Shuri-101/IMU-Dev-board/README.md

# IMU STM32STM32G431CBT6 DEV BOARD:




Hello, this is just a project for me to get some experience and learn about data busses like SPI (Serial Peripheral Interface), UART (Universal Asynchronous Receiver/Transmitter) and I2C (Inter-Integrated Circuit) and learn how to program sensors like IMUs, barometers, altimeters, GPS etc. This because I hope to design a flight computer for a drone or active stabilized rocket so yeah. 

## PCB
### About the board:

This board contains: 
- IMU (LSM6DS3TR-C)
- x6 GPIO headers
- x2 I2C headers (I2C 1 and I2C 2)
- x1 UART header (UART2)
- x2 SPI Headers (SPI 2, SPI3)
- x2 ADC headers
- x2 PWM headers
- x2 5V headers
- x4 3.3V headers
- x6 GND headers

### Schematic:


Since I had 48pins on my MCU I thought might as well use them and connect them to headers so I can use them later to connect other sensors and stuff.

Note for beginners: Decoupling capacitors are meant to smooth out power spikes and dips that might cause logic errors in the MCU, they also act as filtering capacitors keeping noise off sensitive rails like analogue (noise is unwanted voltage that you did not put there) as analogue data is the measure of voltage. 

Example of my decoupling capacitors are: 



Note that the capacitors are placed in parallel to the 3V3 line. 4.7uF is a bulk capacitors meant to refill the small capacitors between the spikes and dips that get drained very quickly during the spikes and dips. 

For more info about decoupling watch: 
https://www.youtube.com/watch?v=u40kX1DYKdA

### Why I chose these parts?

- I chosen the STM32STM32G431CBTX since it offered FPU, CRC and a mathematical accelerator which are needed to control these sensors, I chosen the LQFP-48 package since its easier to solder and it was the only variant available to buy at the time.
- FPU, a floating point unit allows you to work with floating point numbers such as a fraction, decimals etc 100x faster than a MCU without a FPU, since sensors output raw numbers that need to converted into data requires floating point maths hundreds of times per second.
- DSP, Digital Signal Processing lets you do fast repeated multiply-and-add on a stream of numbers, which is needed to do maths for the sensors roughly twice as fast than a MCU without it.

- I chose the LSM6DS3TR-C as its cheap has 6 axis and a +/- 2000 degrees / second and it has +/- 16g which works for learning how to program and design a PCB for an IMU. 

### Layers

#### Layer 1 (Main signal routing layer)
- In this layer I routed most of my signals + decupling / filtering capcitors (since they need to be placed as close to the thing its meant to decoupling / filter around 5mm max) taking care to have proper clearance from aggressive signals such as SCK to avoid crosstalk and interference from other signals.
- I also used local copper pours to create a low impedance route to GND.
- LDO is placed far away from IMU at the opposite end of the board to prevent the heat it generates from interfering with the readings.



#### Layer 2 (Ground Plane):
- This layer is a layer of copper connected ground aka "ground plane" and offers a low impedance path (simple terms path of low total resistance) to GND and also acts as a reference plane for signal return currents.
- Notice I have not routed anything on this layer, this is to maintain a unbroken reference plane otherwise signal return currents will have to loop around interfering with other signals.
- Using a ground plane also makes way way way easier to route your GND traces instead of using long traces back to power supply.
  


#### Layer 3 (3V3 Power Plane):
- This layer is another layer of copper but this time its connected to 3V3 from my LOW Dropout Converter which converts 5V --> 3.3V cause MCUs and my IMU runs on 3.3v logic.
- The 3v3 plane makes it easier to route my power supplies to my components that need it as its saves room as you can see from the picture I just use vias to route up from the plane to the MCU.
- Here you can see I routed signals here because I had no other choice as this board is quite small, this inevitably caused islands of copper to form on the PCB meaning I had to create localised copper pours on layer 3 to stitch these islands togther.



#### Layer 4 (3V3 stitching and Signal routing):
- In this layer I also used it to route signals I could not route on other layers as I had no room.
- I also used this layer to stitch the 3V3 plane up.
- The signals on this layer references with the 3V3 power plane because decoupling capacitors tie 3V3 and GND together.



## BOM:
To get these parts I recommend LCSC since they offer cheap global shipping and are available with JLCPCB assemble option.
To get these parts simply type the LSCC part code into the search bar of their website.
#### Parts:
USING LCSC:
- C967633: IMU

- C529355: MCU

- C6186: LDO

- C20608785: YELLOW LED

- C2894893: USB-C PORT

- C19171391: RED LED

- C33546008: 22uF MLCC XR5 (Filtering)

- C36911367: 100nF MLCC XR7 (Decoupling)

- C107365: 4.7uF MLCC XR7 (Bulk decoupling)

- C53282227: 1uF MLCC XR7

- C519909: 10nF MLCC XR7

- C118848: 5.1K Resistor

- C54921199: 470 Resistor

- C54921203: 4.7K Resistor

- C54921094: 10K Resistor


#### Estimated total for components:


#### PCB manufacturing costs:


#### TOTAL:
TOTAL COSTS: $54.03

## Firmware:
Since I don't know how to code in C and as I mentioned at the start this board is meant to get me to learn how to code, ill just send the config file for the IMU pins ONLY since I dont know what other things I want to plug into the board yet, and that is decide by the end user, but I'll set up the main configs for the MCU like clock SWD(for programming) and pins for the IMU. Also will need to learn fully about clocks, how they work, and how to configure data lines in CUBE MX...
