Shuri-101/IMU-Dev-board/BOM.md

# IMU Dev board – bill of materials

<!-- Generated by Half Life from project cmv2b11c403c001q3gejw6bb5. Edits here are overwritten on the next sync. -->
<!-- Generated: 2026-10-12T01:29:27.425Z -->

> [!NOTE]
> This parts list is mirrored from [Half Life](https://halflife.hackclub.com). Editing it here will not change the platform's copy, and the next sync overwrites this file.

| Week | Tier | Parts funding |
| --- | --- | --- |
| Week 1 | Tier 2 | $65.00 |

| Part | What it's for | Qty | Unit | Total | Vendor |
| --- | --- | --- | --- | --- | --- |
| [LSM6DS3TR-C](https://www.lcsc.com/product-detail/C967633.html) | LGA-14(2.5x3) IMUs (Inertial Measurement Units) RoHS | 2 | $1.53 | $3.06 | [LCSC](https://www.lcsc.com/product-detail/C967633.html) |
| [STM32G431CBT6](https://www.lcsc.com/product-detail/C529355.html) | ARM Cortex-M4F 32 Bit 170MHz LQFP-48(7x7) Microcontrollers RoHS | 2 | $5.07 | $10.14 | [LCSC](https://www.lcsc.com/product-detail/C529355.html) |
| [AMS1117-3.3](https://www.lcsc.com/product-detail/C6186.html) | 3.3V Positive Fixed SOT-223 Voltage Regulators - Linear, Low Drop Out (LDO) Regulators RoHS | 5 | $0.21 | $1.05 | [LCSC](https://www.lcsc.com/product-detail/C6186.html) |
| [YLED0805Y](https://www.lcsc.com/product-detail/C20608785.html) | Yellow 598nm LED Indication - Discrete 1.8V~2.4V 0805 | 50 | $0.01 | $0.50 | [LCSC](https://www.lcsc.com/product-detail/C20608785.html) |
| [HC-TYPE-C-6P-01A](https://www.lcsc.com/product-detail/C2894893.html) | USB-C (USB TYPE-C) Receptacle Connector 6 Position Surface Mount, Right Angle | 10 | $0.05 | $0.50 | [LCSC](https://www.lcsc.com/product-detail/C2894893.html) |
| [YLED0805R](https://www.lcsc.com/product-detail/C19171391.html) | Red 645nm LED Indication - Discrete 1.8V~2.4V 0805 | 100 | $0.01 | $1.00 | [LCSC](https://www.lcsc.com/product-detail/C19171391.html) |
| [HGC0805R5226M160NSLJ](https://www.lcsc.com/product-detail/C33546008.html) | 22uF ±20% 16V Ceramic Capacitor X5R 0805 | 5 | $0.10 | $0.50 | [LCSC](https://www.lcsc.com/product-detail/C33546008.html) |
| [CGA0805X7R104K160KT](https://www.lcsc.com/product-detail/C36911367.html) | 100nF ±10% 16V Ceramic Capacitor X7R 0805 | 100 | $0.01 | $1.00 | [LCSC](https://www.lcsc.com/product-detail/C36911367.html) |
| [CL21B475KOFNNNE](https://www.lcsc.com/product-detail/C107365.html) | 4.7uF ±10% 16V Ceramic Capacitor X7R 0805 | 10 | $0.04 | $0.40 | [LCSC](https://www.lcsc.com/product-detail/C107365.html) |
| [CGA0805X7R105J160MT](https://www.lcsc.com/product-detail/C53282227.html) | 1uF X7R ±5% 16V 0805 Ceramic Capacitors | 10 | $0.04 | $0.40 | [LCSC](https://www.lcsc.com/product-detail/C53282227.html) |
| [CC0805KRX7R7BB103](https://www.lcsc.com/product-detail/C519909.html) | 10nF ±10% 16V Ceramic Capacitor X7R 0805 | 50 | $0.01 | $0.50 | [LCSC](https://www.lcsc.com/product-detail/C519909.html) |
| [RS-05K5101FT](https://www.lcsc.com/product-detail/C118848.html) | 5.1kΩ ±1% 125mW 0805 Thick Film Resistor | 100 | $0.00 | $0.00 | [LCSC / ERROR WITH COST PLS CHECK](https://www.lcsc.com/product-detail/C118848.html) |
| [HRC0805F4700FNTN](https://www.lcsc.com/product-detail/C54921199.html) | 125mW 470Ω 150V Thick Film Resistor ±1% ±100ppm/℃ 0805 Chip Resistor - Surface Mount | 100 | $0.00 | $0.00 | [LCSC / ERROR WITH COST PLS CHECK](https://www.lcsc.com/product-detail/C54921199.html) |
| [HRC0805F4701FNTN](https://www.lcsc.com/product-detail/C54921203.html) | 125mW 4.7kΩ 150V Thick Film Resistor ±1% ±100ppm/℃ 0805 Chip Resistor - Surface Mount | 100 | $0.00 | $0.00 | [LCSC / ERROR WITH COST PLS CHECK](https://www.lcsc.com/product-detail/C54921203.html) |
| [HRC0805F1002FNTN](https://www.lcsc.com/product-detail/C54921094.html) | 10kΩ 125mW 150V Thick Film Resistor ±1% ±100ppm/℃ 0805 Chip Resistor - Surface Mount | 100 | $0.00 | $0.00 | [LCSC / ERROR WITH COST PLS CHECK](https://www.lcsc.com/product-detail/C54921094.html) |
| [PCB+STENCIL](https://jlcpcb.com) | PCB board | 1 | $15.21 | $15.21 | [JLC PCB](https://jlcpcb.com) |
| **Parts subtotal** | — | — | — | **$34.26** | — |
| **Tax & shipping** | — | — | — | **$20.00** | — |
| **Total** | — | — | — | **$54.26** | — |

$10.74 left of the tier's funding.
