Shuri-101/IMU-Dev-board/BOM.csv

Index | LCSC# | MPN | Manufacturer | Package | Customer # | Description | RoHS | Quantity | MOQ | Multiple | Unit Price($) | Extended Price($) | Product Link
1 | C967633 | LSM6DS3TR-C | ST | LGA-14(2.5x3) |  | LGA-14(2.5x3) IMUs (Inertial Measurement Units) RoHS | yes | 2 | 1 | 1 | 1.5307 | 3.06 | https://www.lcsc.com/product-detail/C967633.html
2 | C529355 | STM32G431CBT6 | ST | LQFP-48(7x7) |  | ARM Cortex-M4F 32 Bit 170MHz LQFP-48(7x7) Microcontrollers RoHS | yes | 2 | 1 | 1 | 5.0690 | 10.14 | https://www.lcsc.com/product-detail/C529355.html
3 | C6186 | AMS1117-3.3 | Advanced Monolithic Systems | SOT-223 |  | 3.3V Positive Fixed SOT-223 Voltage Regulators - Linear, Low Drop Out (LDO) Regulators RoHS | yes | 5 | 5 | 5 | 0.2100 | 1.05 | https://www.lcsc.com/product-detail/C6186.html
4 | C20608785 | YLED0805Y | YONGYUTAI | 0805 |  | Yellow 598nm LED Indication - Discrete 1.8V~2.4V 0805 | yes | 50 | 50 | 50 | 0.0125 | 0.63 | https://www.lcsc.com/product-detail/C20608785.html
5 | C2894893 | HC-TYPE-C-6P-01A | HCTL | SMD |  | USB-C (USB TYPE-C) Receptacle Connector 6 Position Surface Mount, Right Angle | yes | 10 | 10 | 10 | 0.0461 | 0.46 | https://www.lcsc.com/product-detail/C2894893.html
6 | C19171391 | YLED0805R | YONGYUTAI | 0805 |  | Red 645nm LED Indication - Discrete 1.8V~2.4V 0805 | yes | 100 | 100 | 100 | 0.0078 | 0.78 | https://www.lcsc.com/product-detail/C19171391.html
7 | C33546008 | HGC0805R5226M160NSLJ | Chinocera | 0805 |  | 22uF ±20% 16V Ceramic Capacitor X5R 0805 | yes | 5 | 5 | 5 | 0.0971 | 0.49 | https://www.lcsc.com/product-detail/C33546008.html
8 | C36911367 | CGA0805X7R104K160KT | HRE | 0805 |  | 100nF ±10% 16V Ceramic Capacitor X7R 0805 | yes | 100 | 100 | 100 | 0.0079 | 0.79 | https://www.lcsc.com/product-detail/C36911367.html
9 | C107365 | CL21B475KOFNNNE | Samsung Electro-Mechanics | 0805 |  | 4.7uF ±10% 16V Ceramic Capacitor X7R 0805 | yes | 10 | 10 | 10 | 0.0367 | 0.37 | https://www.lcsc.com/product-detail/C107365.html
10 | C53282227 | CGA0805X7R105J160MT | HRE | 0805 |  | 1uF X7R ±5% 16V 0805 Ceramic Capacitors | yes | 10 | 10 | 10 | 0.0403 | 0.40 | https://www.lcsc.com/product-detail/C53282227.html
11 | C519909 | CC0805KRX7R7BB103 | YAGEO | 0805 |  | 10nF ±10% 16V Ceramic Capacitor X7R 0805 | yes | 50 | 50 | 50 | 0.0116 | 0.58 | https://www.lcsc.com/product-detail/C519909.html
12 | C118848 | RS-05K5101FT | FH | 0805 |  | 5.1kΩ ±1% 125mW 0805 Thick Film Resistor | yes | 100 | 100 | 100 | 0.0036 | 0.36 | https://www.lcsc.com/product-detail/C118848.html
13 | C54921199 | HRC0805F4700FNTN | HWA CHN | 0805 |  | 125mW 470Ω 150V Thick Film Resistor ±1% ±100ppm/℃ 0805 Chip Resistor - Surface Mount | yes | 100 | 100 | 100 | 0.0020 | 0.20 | https://www.lcsc.com/product-detail/C54921199.html
14 | C54921203 | HRC0805F4701FNTN | HWA CHN | 0805 |  | 125mW 4.7kΩ 150V Thick Film Resistor ±1% ±100ppm/℃ 0805 Chip Resistor - Surface Mount | yes | 100 | 100 | 100 | 0.0020 | 0.20 | https://www.lcsc.com/product-detail/C54921203.html
15 | C54921094 | HRC0805F1002FNTN | HWA CHN | 0805 |  | 10kΩ 125mW 150V Thick Film Resistor ±1% ±100ppm/℃ 0805 Chip Resistor - Surface Mount | yes | 100 | 100 | 100 | 0.0021 | 0.21 | https://www.lcsc.com/product-detail/C54921094.html
