Shuri-101/IMU-Dev-board/IMU Dev board.kicad_pcb

## KiCad design IMU Dev board.kicad_pcb (2026-10-11)

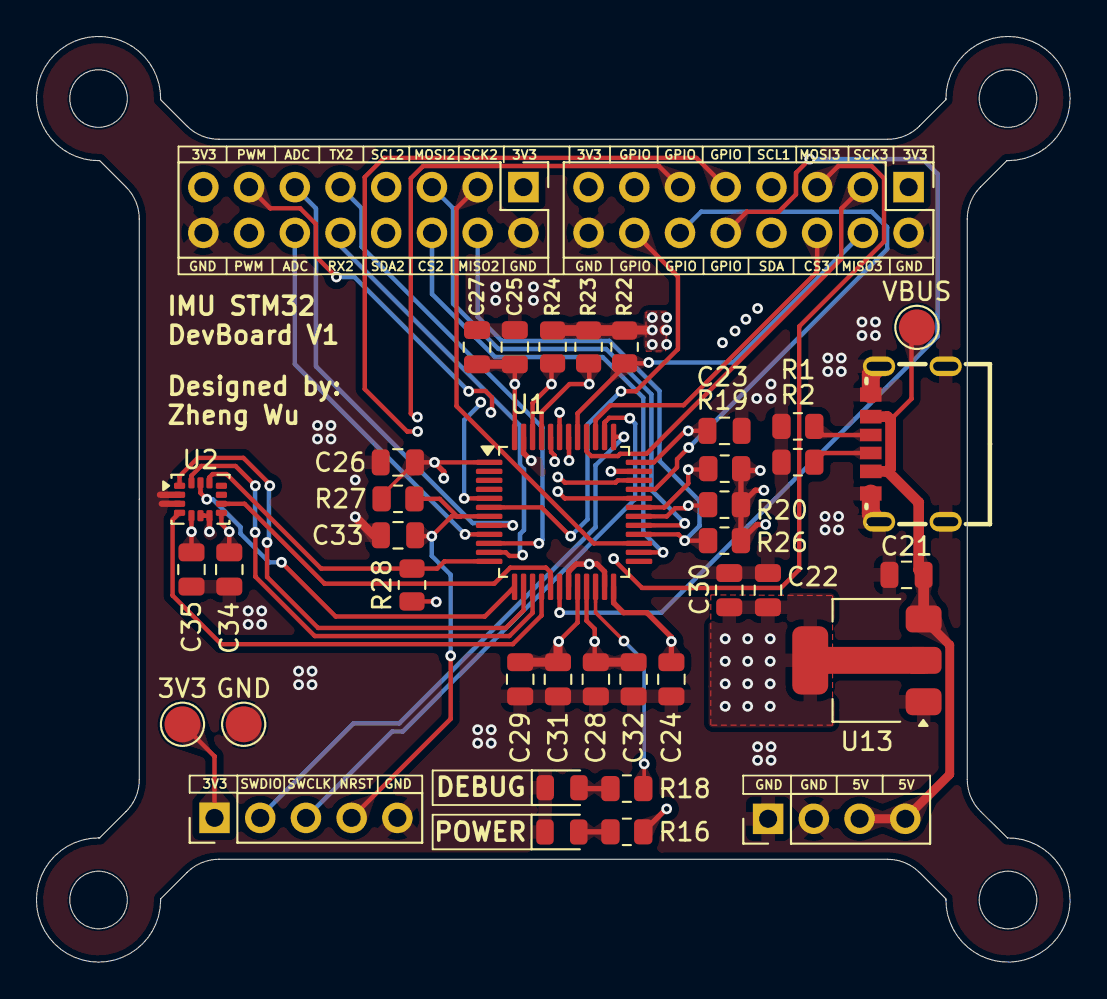
[picture p1: board IMU Dev board.kicad_pcb from above]

Board: 4 copper layers, 57.4 x 51.4 mm, 44 parts (0 on the bottom side), 41 nets.

Parts:
3V3: TestPoint; TestPoint_Pad_D2.0mm
C21, C22: 22uF; C_0805_2012Metric
C23, C24, C25, C26, C28, C30, C33, C34, C35: 100nF; C_0805_2012Metric
C27: 4.7uF; C_0805_2012Metric
C29, C32: 1uF; C_0805_2012Metric
C31: 10nF; C_0805_2012Metric
DEBUG: YELLOW; LED_0805_2012Metric
GND: TestPoint; TestPoint_Pad_D2.0mm
H1, H2, H3, H4: MountingHole; MountingHole_3.2mm_M3
J1: Conn_01x05_Pin; PinHeader_1x05_P2.54mm_Vertical
J3, J4: Conn_02x08_Odd_Even; PinHeader_2x08_P2.54mm_Vertical
J7: Conn_01x04_Pin; PinHeader_1x04_P2.54mm_Vertical
POWER: GREEN; LED_0805_2012Metric
R1, R2: 5.1K; R_0805_2012Metric
R16, R18: 470; R_0805_2012Metric
R19, R20, R23, R24: 4.7k; R_0805_2012Metric
R22, R26, R27, R28: 10k; R_0805_2012Metric
U1: STM32G431CBTx; LQFP-48_7x7mm_P0.5mm
U2: LSM6DS3TR-C (Pin 7 --> GND); LGA-14_3x2.5mm_P0.5mm_LayoutBorder3x4y
U13: AMS1117-3.3; SOT-223-3_TabPin2
USB1: HC-TYPE-C-6P-01A; USB-C-SMD_HC-TYPE-C-6P-01A
VBUS: TestPoint; TestPoint_Pad_D2.0mm

Connections:
3V3: 3V3.1 (1_1), C22.1, C23.1, C24.1, C25.1, C26.1, C27.1, C28.1, C29.1, C30.2, C31.2, C32.1, C34.1, C35.1, J1.1, J3.1, J3.15, J4.1, J4.15, R16.1, R19.2, R20.2, R22.2, R23.2, R24.2, R26.2, R27.2, R28.2, U1.1 (VBAT), U1.20 (VREF+), U1.21 (VDDA), U1.24 (VDD), U1.36 (VDD), U1.48 (VDD), U2.5 (VDDIO), U2.8 (VDD), U13.2 (VO)
ADC PA0: J3.11, U1.8 (PA0)
ADC PA1: J3.12, U1.9 (PA1)
CS 1: R28.1, U1.12 (PA4), U2.12 (CS)
CS 2: J3.6, U1.26 (PB12)
CS 3: J4.6, U1.39 (PA15)
DEBUG_LED: R18.1, U1.22 (PB10)
GND: C21.1, C22.2, C23.2, C24.2, C25.2, C26.2, C27.2, C28.2, C29.2, C30.1, C31.1, C32.2, C33.2, C34.2, C35.2, DEBUG.1 (K), GND.1 (1_1), J1.5, J3.2, J3.16, J4.2, J4.16, J7.1, J7.2, POWER.1 (K), R1.2, R2.1, U1.19 (VSSA), U1.23 (VSS), U1.35 (VSS), U1.47 (VSS), U2.2 (SDX), U2.3 (SCX), U2.6 (GND), U2.7 (GND), U13.1 (GND), USB1.1, USB1.2, USB1.3, USB1.4, USB1.A12, USB1.B12
GPIO PA10: J4.9, U1.32 (PA10)
GPIO PA11: J4.12, U1.33 (PA11)
GPIO PA12: J4.11, U1.34 (PA12)
GPIO PB2: J4.10, U1.18 (PB2)
GPIO PF0: J4.13, U1.5 (PF0)
GPIO PF1: J4.14, U1.6 (PF1)
INT1: U1.16 (PB0), U2.4 (INT1)
INT2: U1.17 (PB1), U2.9 (INT2)
MISO 1: U1.14 (PA6), U2.1 (SDO/SA0)
MISO 2: J3.4, R26.1, U1.28 (PB14)
MISO 3: J4.4, R22.1, U1.41 (PB4)
MOSI 1: U1.15 (PA7), U2.14 (SDA)
MOSI 2: J3.5, U1.29 (PB15)
MOSI 3: J4.5, U1.42 (PB5)
NRST: C33.1, J1.4, R27.1, U1.7 (PG10)
unnamed: POWER.2 (A), R16.2
unnamed: DEBUG.2 (A), R18.2
unnamed: R1.1, USB1.B5
unnamed: R2.2, USB1.A5
PWM/RX IN 1: J3.14, U1.44 (PB7)
PWM/TX OUT 1: J3.13, U1.43 (PB6)
RX IN 2: J3.10, U1.11 (PA3)
SCK 1: U1.13 (PA5), U2.13 (SCL)
SCK 2: J3.3, U1.27 (PB13)
SCK 3: J4.3, U1.40 (PB3)
SCL 1: J4.7, R23.1, U1.45 (PB8)
SCL 2: J3.7, R19.1, U1.31 (PA9)
SDA 1: J4.8, R24.1, U1.46 (PB9)
SDA 2: J3.8, R20.1, U1.30 (PA8)
SWCLK: J1.3, U1.38 (PA14)
SWDIO: J1.2, U1.37 (PA13)
TX OUT 2: J3.9, U1.10 (PA2)
VBUS: C21.2, J7.3, J7.4, U13.3 (VI), USB1.A9, USB1.B9, VBUS.1 (1_1)
