Shuri-101/IMU-Dev-board/firmware/Firmware.ioc

Mcu.UserName=STM32G431CBTx
PA13.Signal=SYS_JTMS-SWDIO
PA14.Signal=SYS_JTCK-SWCLK
PA4.GPIO_Label=IMU-CS
PA4.Signal=GPIO_Output
PA5.Signal=SPI1_SCK
PA6.Signal=SPI1_MISO
PA7.Signal=SPI1_MOSI
PB0.GPIO_Label=IMU-INT1
PB0.Signal=GPXTI0
PB1.GPIO_Label=IMU-INT2
PB1.Signal=GPXTI1
PB10.Signal=GPIO_Output
