Shuri-101/IMU-Dev-board/firmware/Core/Inc/main.h

#define IMU_CS_Pin GPIO_PIN_4
#define IMU_CS_GPIO_Port GPIOA
#define IMU_INT1_Pin GPIO_PIN_0
#define IMU_INT1_GPIO_Port GPIOB
#define IMU_INT1_EXTI_IRQn EXTI0_IRQn
#define IMU_INT2_Pin GPIO_PIN_1
#define IMU_INT2_GPIO_Port GPIOB
#define IMU_INT2_EXTI_IRQn EXTI1_IRQn
