Shuri-101/IMU-Dev-board/(commit log)

2026-10-10 Sync PCBs from Half Life
2026-10-11 Create PCB design files
2026-10-11 Add files via upload
    PCB Design configured by JLCPCB Fabrication tool kit
    [bom.csv, designators.csv, positions.csv]
2026-10-11 Add files via upload
    KI cad Files
    [IMU Dev board.kicad_pcb, IMU Dev board.kicad_sch]
2026-10-12 Add files via upload
    SHOPPING CART FROM LCSC
    [export_cart_20261012_084030.csv]
2026-10-13 Sync IMU Dev board from Half Life
2026-10-14 Expand README with PCB details and schematic
    Added details about the PCB and its components, including IMU, GPIO, I2C, UART, SPI, ADC, and PWM headers.
2026-10-14 Enhance board description formatting in README
    Reformatted the description of the board's features for clarity.
2026-10-14 Fix typo in IMU description in README.md
